MarkG98/3DScanner/Pictures/Scanner.JPG

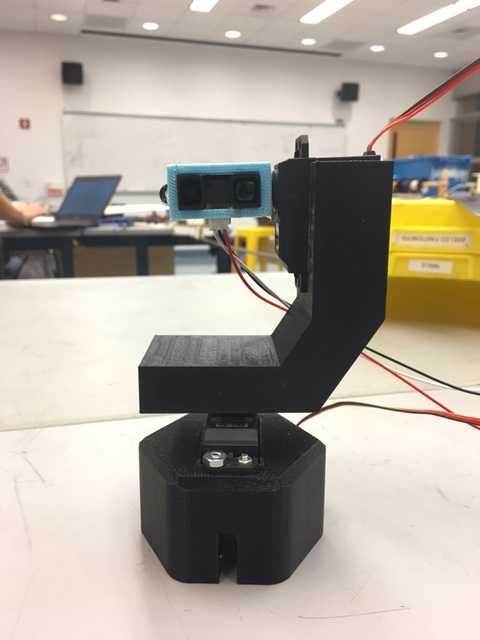
Pictures/Scanner.JPG
