MarkG98/3DScanner/README.md

# 3DScanner
3D Scanner using an Arduino Uno (R3), two servos and an IR sensor
