MarkG98/3DScanner/Pictures/ColumnLabeled.pdf

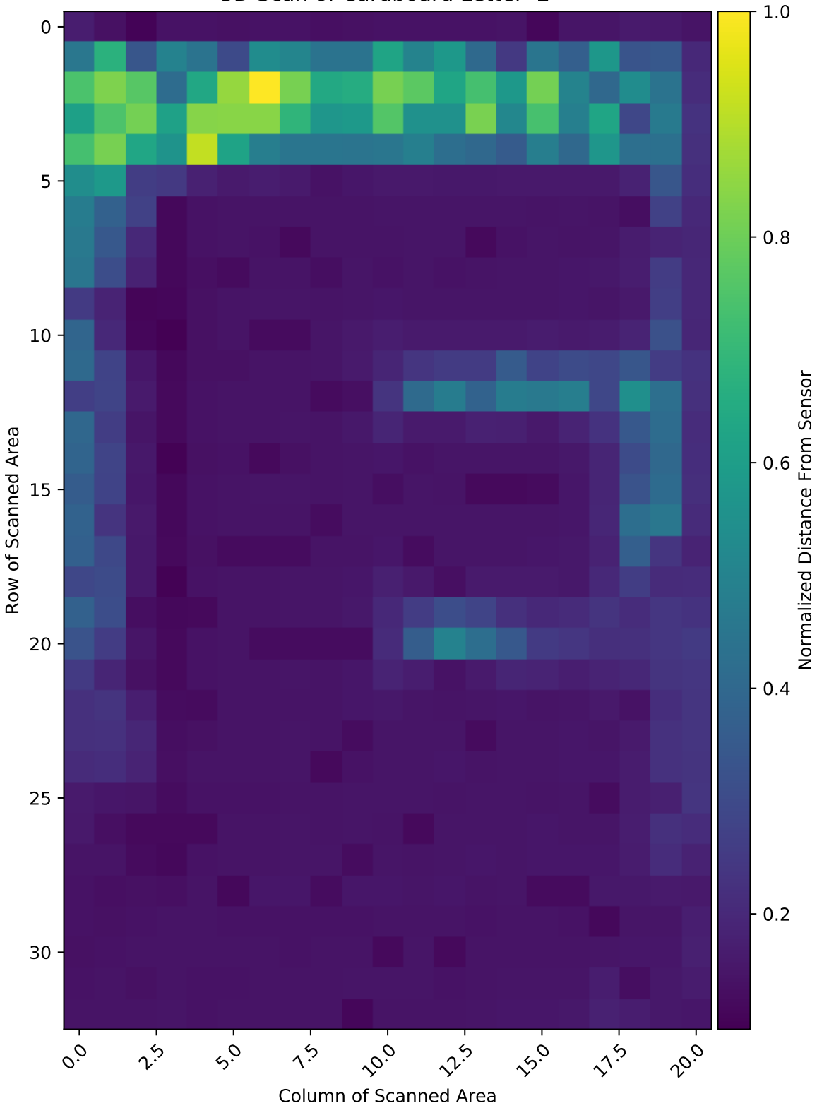
[picture p7: figure]
Column of Scanned Area; Row of Scanned Area; Normalized Distance From Sensor

### 3D Scan of Cardboard Letter 'E'
