MarkG98/3DScanner/Pictures/DegreeLabeled.pdf

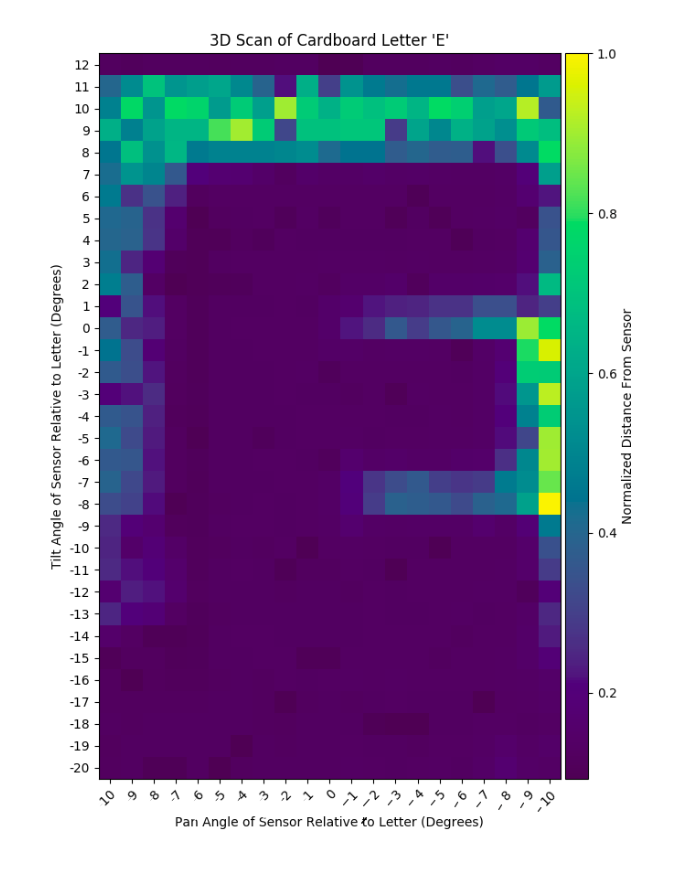
[picture p8: page 1]
